stagnert/AutoDoc-9000/README.md

# AutoDoc-9000
The contactless temperature sensor was created to give an accurate temperature reading for any institution that needs a reliable way of detecting if a user has a fever, without them needing to touch the device.
