stagnert/AutoDoc-9000/schematics/PCB_AutoDoc9000.png

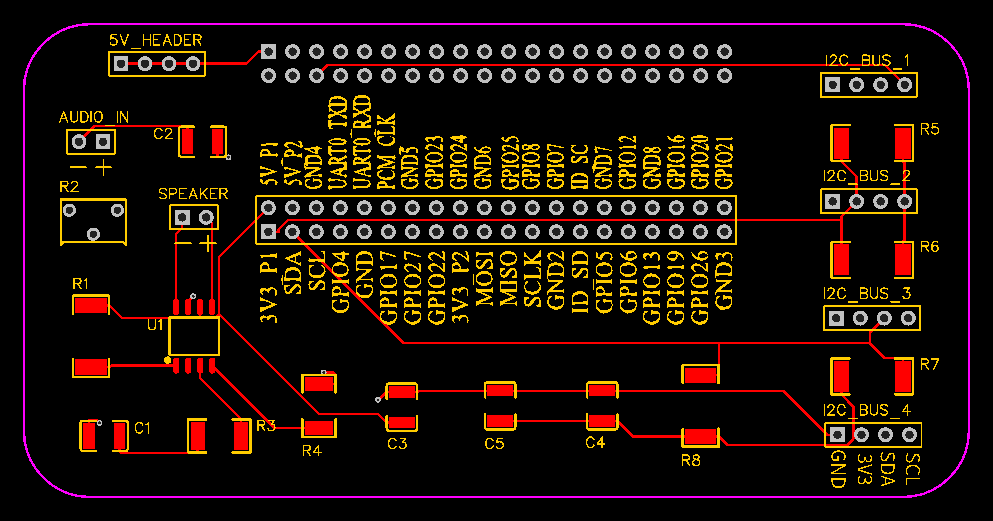
schematics/PCB_AutoDoc9000.png
