stagnert/AutoDoc-9000/docs/AutoDoc9000_BOM.pdf

Electronics BOM

Quantity | Unit | Reference Designators | Part name | Part Number | Cost | URL to part | URL to Data sheet
1 each | Microprocessor | Raspberry Pi Zero W | 3708 | $14.00 https://www.adafruit.com/product/3708 https://www.raspberrypi.org/products/raspberry-pi-zero-w/
1 each | Digital_Display | 128x32 Mini OLED Display | 3527 | $14.95 https://www.adafruit.com/product/3527 https://cdn-learn.adafruit.com/downloads/pdf/adafruit-pioled-128x32-mini-oled-for-raspberry-pi.pdf
1 each | Temp_sensor | Contact-less Infrared Scanner | MLX90614 | $15.95 https://www.adafruit.com/product/1747 https://cdn-shop.adafruit.com/datasheets/MLX90614.pdf
1 each | Input_sensor | IR Beam Break Sensor | 2167 | $1.95 adafruit.com/product/2167 https://media.digikey.com/pdf/Data%20Sheets/Adafruit%20PDFs/2168_Web.pdf
2 each | AUDIO_IN, SPEAKER | HDR-F-2.54_1x2 | C49661 | $0.03 https://lcsc.com/product-detail/Female-Header_2-54-1-2PFemale_C49661.html https://datasheet.lcsc.com/lcsc/1811092011_BOOMELE-Boom-Precision-Elec-C49661_C49661.pdf
4 each | C1,C2,C4,C5 | 100nF | C527375 | $0.12 https://lcsc.com/product-detail/Multilayer-Ceramic-Capacitors-MLCC-SMD-SMT_YAGEO-CC1210KKX7R0BB104_C527375.html https://datasheet.lcsc.com/lcsc/2005261833_YAGEO-CC1210KKX7R0BB104_C527375.pdf
1 each | C3 | 10uF | C380537 | $0.25 https://lcsc.com/product-detail/Multilayer-Ceramic-Capacitors-MLCC-SMD-SMT_Samsung-Electro-Mechanics-CL32A106KBJNNNE_C380537.html https://datasheet.lcsc.com/lcsc/1912111437_Samsung-Electro-Mechanics-CL32A106KBJNNNE_C380537.pdf
1 each | F_HEADER | HDR-F-2.54_2x20 | C50982 | $0.16 https://lcsc.com/product-detail/Pin-Header-Female-Header_BOOMELE-Boom-Precision-Elec-C50982_C50982.html https://datasheet.lcsc.com/lcsc/1811111512_BOOMELE-Boom-Precision-Elec-C50982_C50982.pdf
5 each | 5V_HEADER, I2C_BUS_1, I2C_BUS_2, I2C_BUS_3, I2C_BUS_4 | HDR-F-2.54_1x4 | C225501 | $0.09 https://lcsc.com/product-detail/Pin-Header-Female-Header_CJT-Changjiang-Connectors-A2541HWV-4P_C225501.html https://datasheet.lcsc.com/lcsc/2010160505_CJT-Changjiang-Connectors-A2541HWV-4P_C225501.pdf
1 each | M_HEADER | HDR-M-2.54_2x20 | C50980 | $0.12 https://lcsc.com/product-detail/Pin-Header-Female-Header_BOOMELE-Boom-Precision-Elec-C50980_C50980.html https://datasheet.lcsc.com/lcsc/1811151411_BOOMELE-Boom-Precision-Elec-C50980_C50980.pdf
5 each | R1, R5, R6, R7, R8 | 10K | C270956 | $0.03 https://lcsc.com/product-detail/Chip-Resistor-Surface-Mount_UNI-ROYAL-Uniroyal-Elec-25121WF1002T4E_C270956.html https://datasheet.lcsc.com/lcsc/1810301128_UNI-ROYAL-Uniroyal-Elec-25121WF1002T4E_C270956.pdf
1 each | R2 | 10K | C81167 | $0.32 https://lcsc.com/product-detail/Variable-Resistors-Potentiometers_BOURNS-3362W-1-103LF_C81167.html https://datasheet.lcsc.com/lcsc/1809291908_BOURNS-3362W-1-103LF_C81167.pdf
2 each | R3,R4 | 100 | C63036 | $0.04 https://lcsc.com/product-detail/Chip-Resistor-Surface-Mount_UNI-ROYAL-Uniroyal-Elec-181207F1000T4E_C63036.html https://datasheet.lcsc.com/lcsc/1912111437_UNI-ROYAL-Uniroyal-Elec-181207F1000T4E_C63036.pdf
1 each | U1 | PAM8302AADCR | C112137 | $0.23 https://lcsc.com/product-detail/Audio-Power-OpAmps_Diodes-Incorporated-PAM8302AADCR_C112137.html https://datasheet.lcsc.com/lcsc/1809192027_Diodes-Incorporated-PAM8302AADCR_C112137.pdf
1 each | JLCPCB | PCB | Y3-3565453A | $20.00
1 each | N/A | SAMSUNG EVO Select 64GB microSDXC | MB-ME64HA | $10.99 http://www.amazon.com/dp/B08879MG33 (https://www.amazon.com/dp/B08879MG33?psc=1&ref=ppx_yo2_dt_b_product_details)
| | | | Subtotal: | $79.23

Enclosure BOM
Quantity Size | Part in Assembly | Length | Estimated Cost
3 M4 | Temperature Scanner Mount to Backboard | 12-15mm | $1
8 M4 | Beam Break Sensor Mount to Backboard | 13-15mm | $3
4 M3 | Raspberry Pi Mount to Backboard | 10-13mm | $1
1 M3 | OLED Mount to Backboard | 8-10mm | $1
4 M4 | Speaker Mount to Backboard | 25-27mm | $1
2 M3 | Beam Break Sensor Mount | 13-15mm | $1
4 | Command Strips | $3
1 Kg | | 3D Printer Fillament for Enclosure | | $25
1 | 1/4" Brass nut | $4
Subtotal: | $36
Total: | $115
