stagnert/AutoDoc-9000/schematics/CAD/Beam_Break_Mount_V2.STL

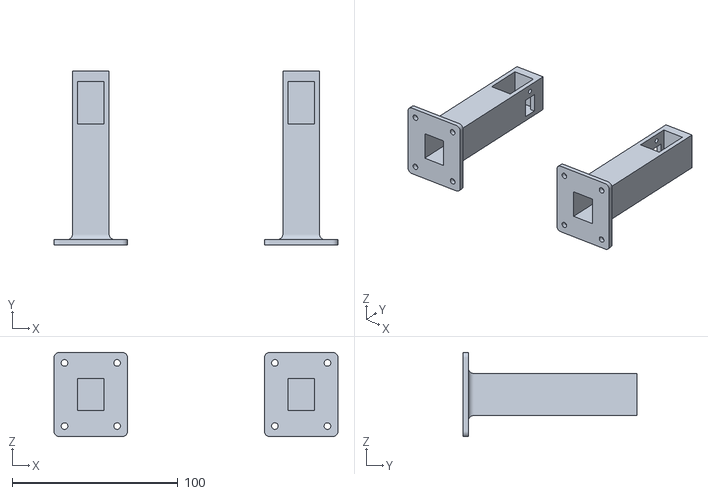
[picture p3: CAD file, 2021-05-30]
schematics/CAD/Beam_Break_Mount_V2.STL
171.4 x 104.8 x 50.8
