stagnert/AutoDoc-9000/schematics/CAD/Speaker_Standoff.STL

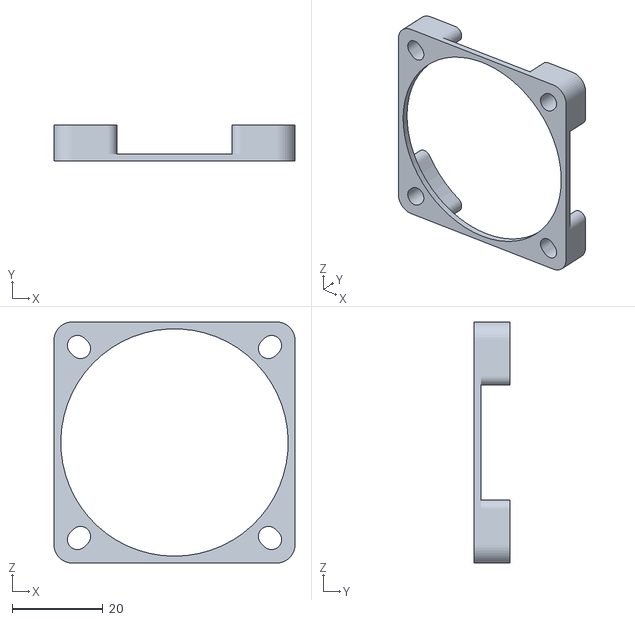
[picture p4: CAD file, 2021-05-30]
schematics/CAD/Speaker_Standoff.STL
53.0 x 7.94 x 53.0
