stagnert/AutoDoc-9000/schematics/CAD/Speaker_Grill.STL

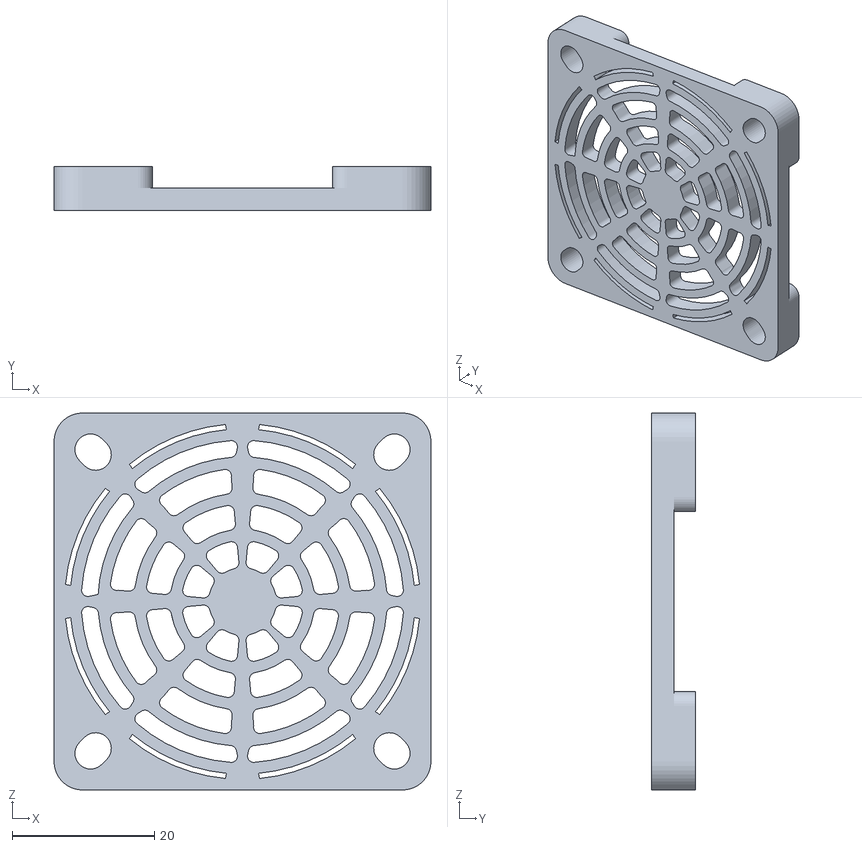
[picture p5: CAD file, 2021-05-30]
schematics/CAD/Speaker_Grill.STL
53.0 x 6.18 x 53.0
