stagnert/AutoDoc-9000/schematics/CAD/Scanner_Mount_End_Piece_V2.STL

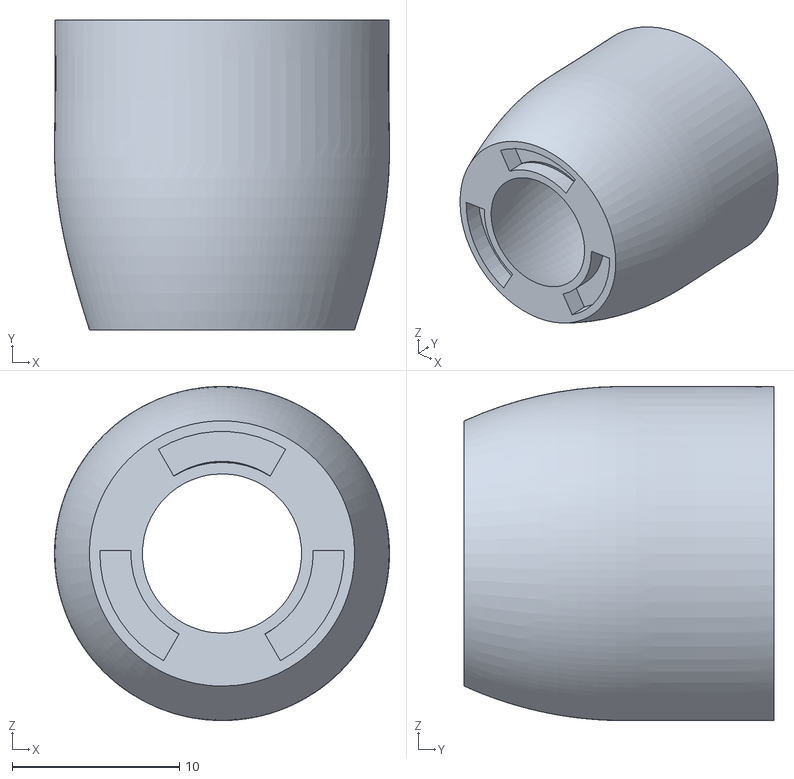
[picture p6: CAD file, 2021-05-30]
schematics/CAD/Scanner_Mount_End_Piece_V2.STL
20.0 x 18.5 x 20.0
