stagnert/AutoDoc-9000/schematics/CAD/Scanner_Mount.STL

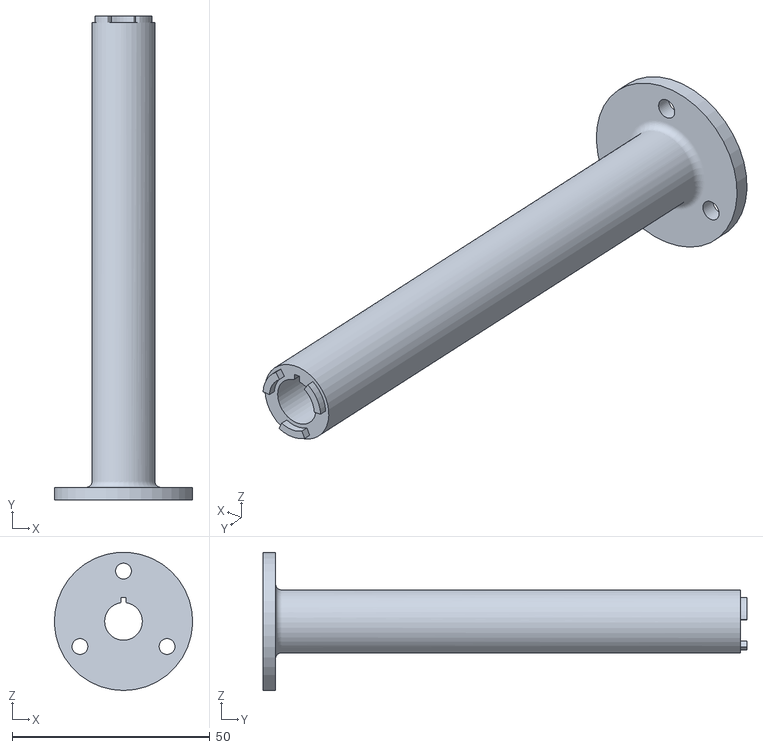
[picture p7: CAD file, 2021-05-30]
schematics/CAD/Scanner_Mount.STL
34.9 x 122.2 x 34.9
