stagnert/AutoDoc-9000/schematics/CAD/Backboard.STL

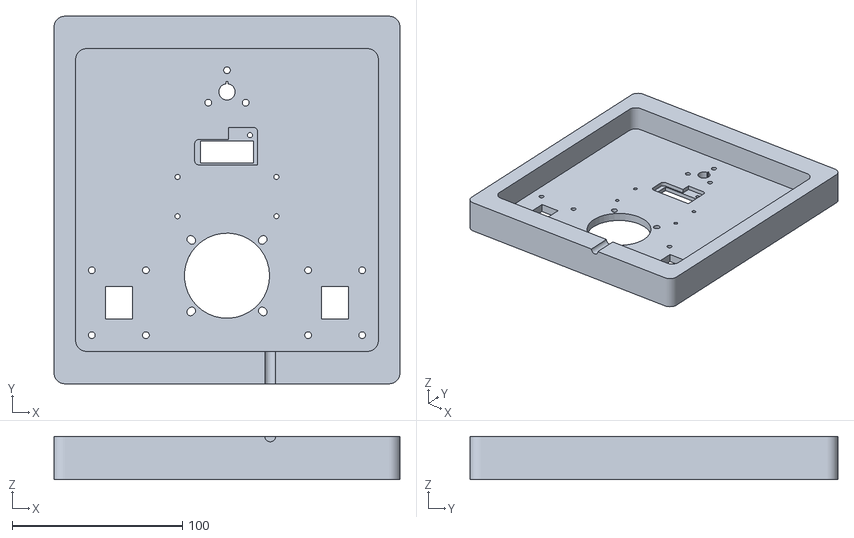
[picture p8: CAD file, 2021-05-30]
schematics/CAD/Backboard.STL
203.2 x 215.9 x 25.4
