stagnert/AutoDoc-9000/docs/AutoDoc9000_Developer_Guide.pdf

## Overview:

This project is intended to be an intuitive, contactless way for multiple users to scan and record their temperature. The system alerts the user if a fever is detected via an OLED screen and an audible noise. The user information is stored onto a micro SD card until it is manually deleted.

## Electrical Specifications:

Part | Electrical Specifications
Raspberry Pi Zero W | 5 v, 2 mA
128x32 Mini OLED Display | 5 v, 21.1 mA
HDR-F-2.54_1x2 (speaker) | 5 v, 500mA
IR Beam Break Sensor | 3.3 v, 10mA
| | 3.3v, 25mA

Melexis Contactless Infrared Sensor -
MLX90614

## User Guide:

First plug the device in. To start a new scan, wave your hand between the beam break sensor mounts. This will display your patient number and instruct you to place your head in front of the scanner. Follow these instructions, and it will display the measured temperature and alert you if it detects a fever. To access the stored patient data, you must SSH into the Linux system running on the Raspberry Pi Zero, and open the file “User_Data.csv”.

## Developer Guide:

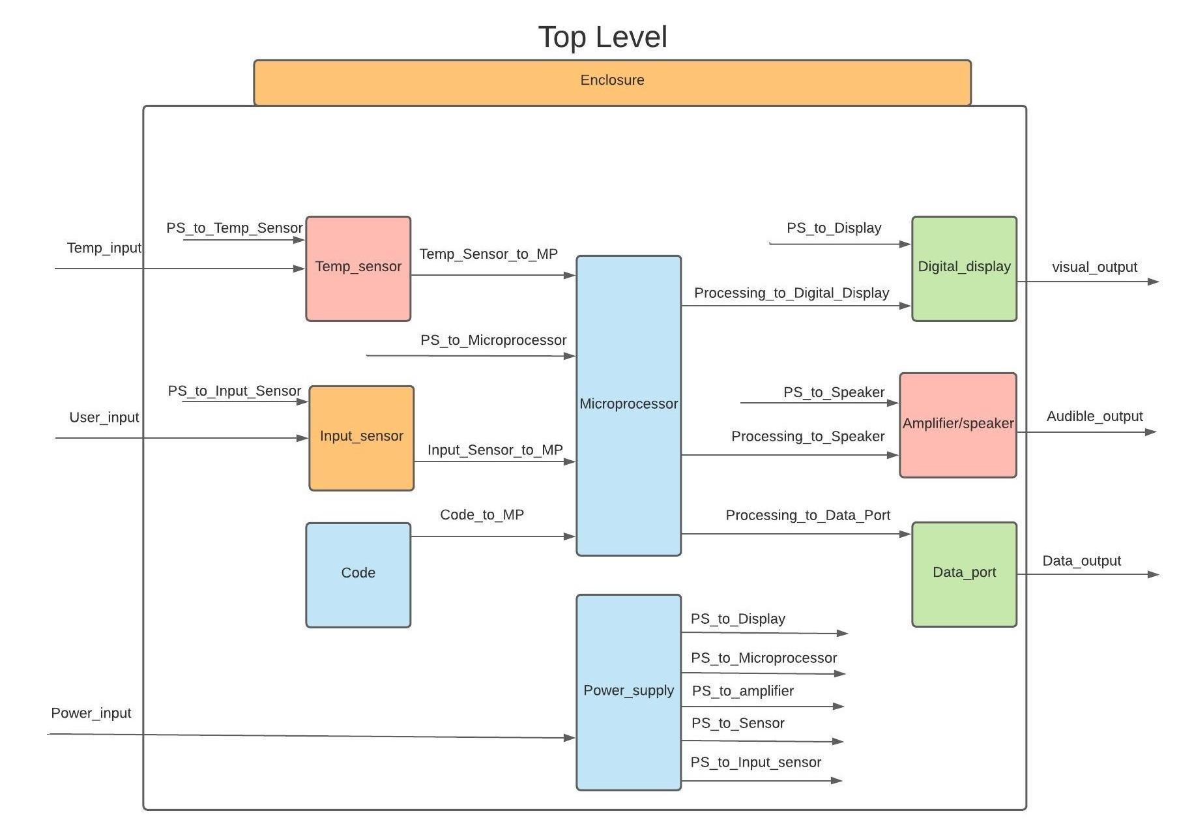
[picture p9: figure]

Figure 1: Top level block diagram

This figure shows the communication between the different parts of the system. In order for the system to be contactless, the temperature sensor needs to be an infrared sensor, and the input sensor needs to be a beam break. The beam break sensor is essentially acting as a button that is used to detect when the user is ready to begin a scan. The data port also has options that would work, such as a USB flash drive, or an SD card. The amplifier is built into the PCB, and the temperature sensor and digital display both communicate with the processor through an I2C bus built into the PCB. The power supply is built into the Raspberry Pi Zero that also functions as the microprocessor.

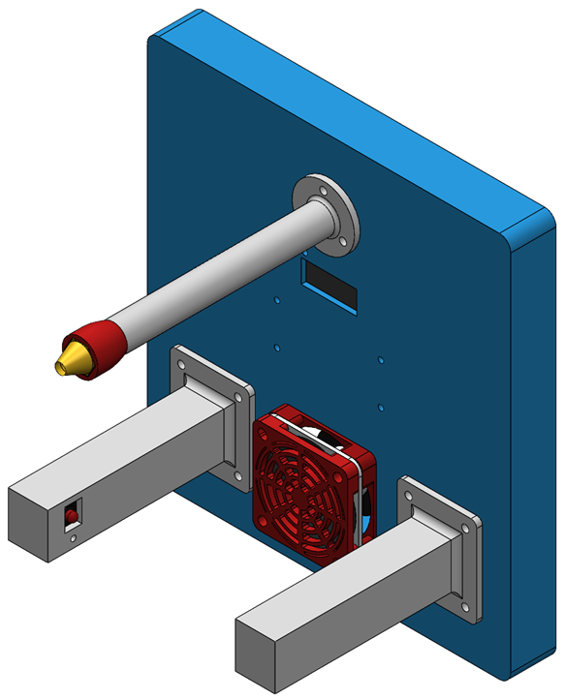
[picture p10: figure]

Figure 2: 3D model of the device

The device enclosure was mostly 3D printed in 7 parts; the backboard(blue), the temperature sensor mount (top white), the temperature sensor end (top red), the left and right beam break sensor mounts (bottom white) and the speaker mount and grill (bottom red). It also requires a brass fitting to focus the temperature scanner, and several screws to attach the pieces together. The exact screws necessary are shown in the “Part Information” section of this guide.

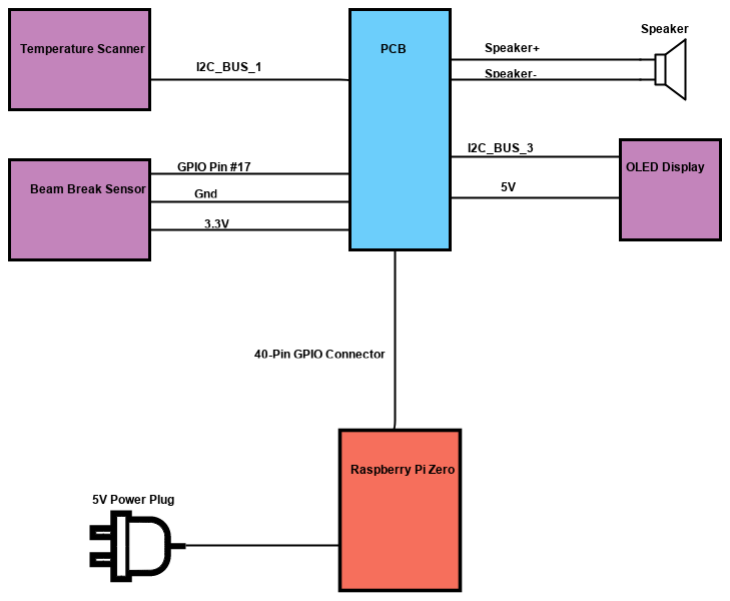
[picture p11: figure]

Figure 3: Top level system schematic

This is the top level schematic of the system. The Raspberry Pi is connected directly on to the PCB through a 40-pin GPIO connector, and provides the power and processing to the rest of the system. The PCB also has a 40-pin GPIO passthrough so that the components can connect to it as if they were connected directly to the Raspberry Pi, and allow for additional components to be connected later.

## PCB Information:

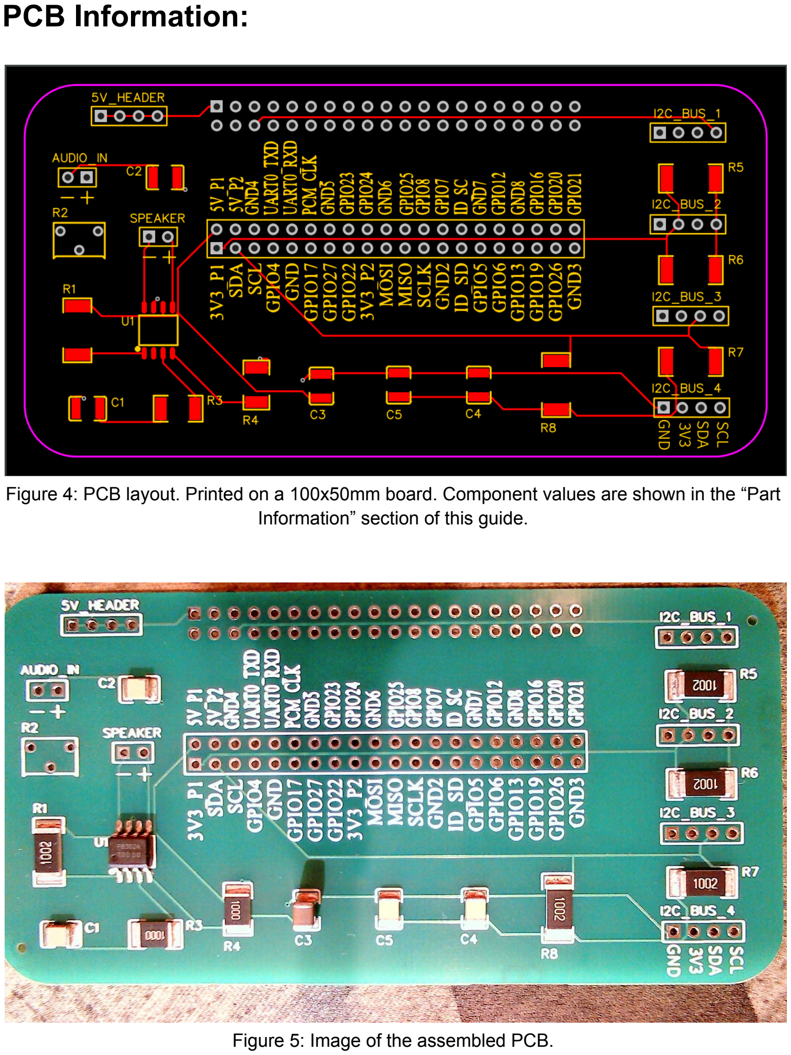
[picture p12: page 5]

Figure 4: PCB layout. Printed on a 100x50mm board. Component values are shown in the “Part Information” section of this guide.

Figure 5: Image of the assembled PCB.

## Part Information:

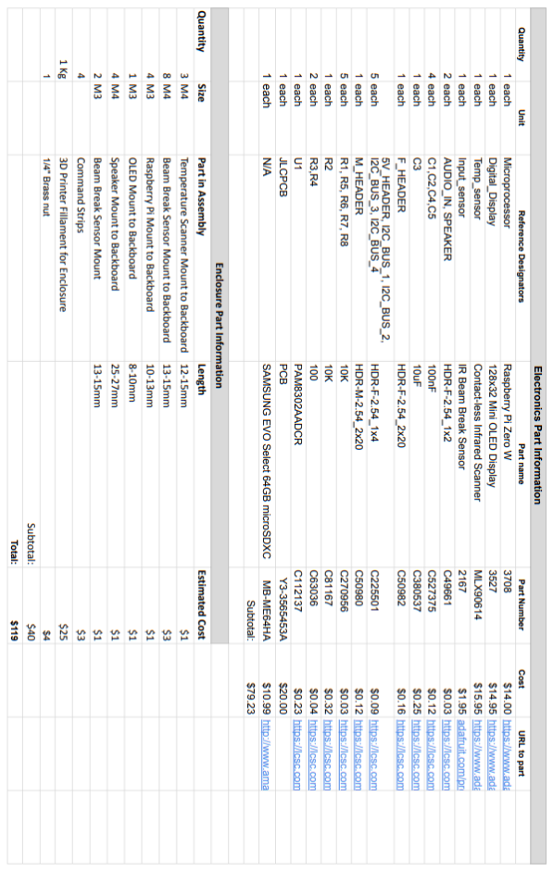
[picture p13: figure]
