stagnert/AutoDoc-9000/schematics/Schematic_AutoDoc9000.pdf

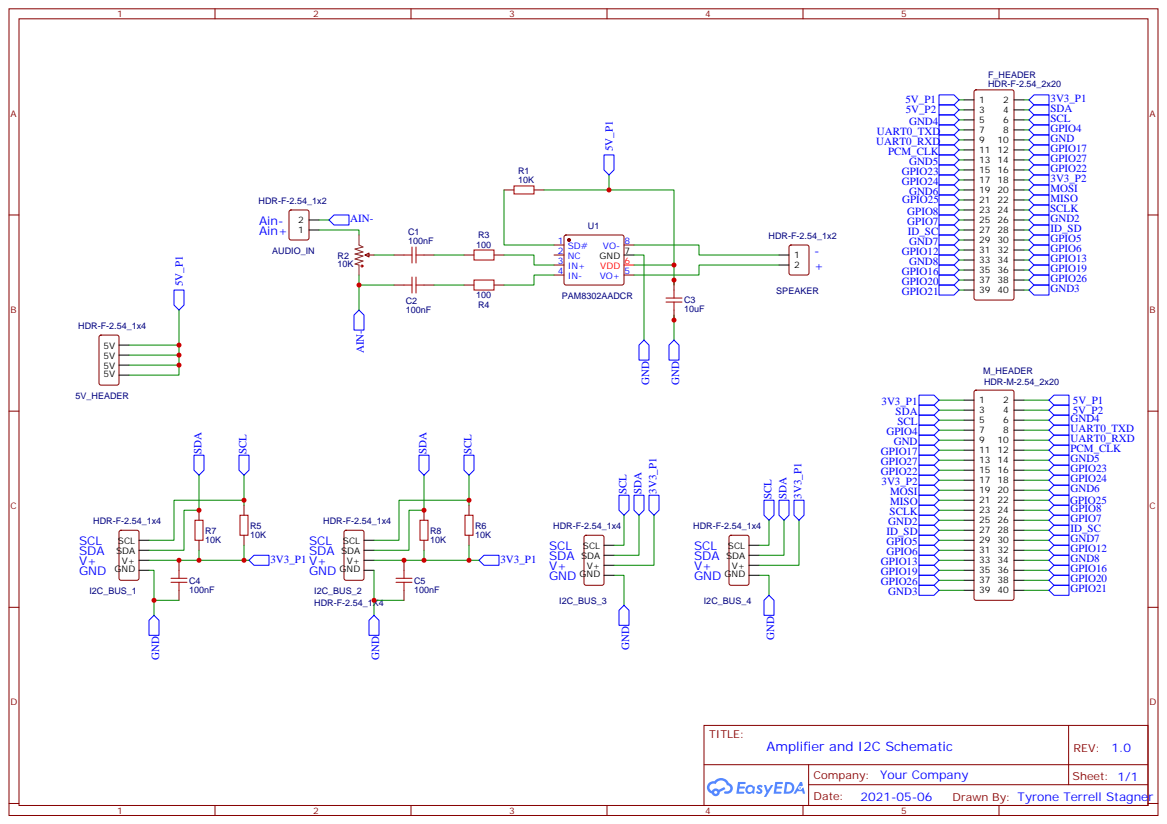
[picture p32: page 1]

Drawn By: Tyrone Terrell Stagner
